harishadithyasBME/ecg-mac-accelerator-fpga/hardware/answer_key/answer_key_info.txt

ANSWER KEY - 16 real test beats, expected outputs of the validated fixed-point model

One value per line, 4 hex digits (16-bit two's complement); decision and label files: 1 hex digit.
Beat k's block starts at line k * (values per beat) of each file.

file                 values/beat  layout inside one beat
beats_in.hex         260          sample number 0..259, Q4.12 (the input buffer)
exp_conv1_relu.hex   2048         filter*256 + position, after ReLU, before pooling (the order conv1 results come out)
exp_conv1_pool.hex   1024         channel*128 + pooled position, Q6.10 (activation buffer A)
exp_conv2_relu.hex   1984         filter*124 + position, after ReLU, before pooling
exp_conv2_pool.hex   992          channel*62 + pooled position, Q6.10 = the flattened 992 values (activation buffer B)
exp_fc1.hex          32           neuron 0..31, Q7.9, after ReLU (activation buffer C)
exp_fc2.hex          2            score 0 (Normal), score 1 (Abnormal), Q6.10
exp_decision.hex     1            1 = Abnormal (score 1 > score 0), 0 = Normal
beat_labels.hex      1            true class from the data set (1 = Abnormal)

BEATS
#   test beat   true  pred  score0     score1     sat(c1,c2,fc1,fc2)  why chosen
0   19138       Nor   Nor   1.4893     -1.3457    0,0,0,0             typical Normal
1   12443       Abn   Abn   -6.8301    8.2842     0,0,0,0             typical Abnormal
2   5748        Nor   Abn   0.5811     3.6475     0,0,4,0             fc1 saturates (4 value(s))
3   5681        Nor   Abn   0.6689     2.2168     0,0,1,0             fc1 saturates (1 value(s))
4   5208        Nor   Abn   -3.3633    0.0381     0,0,0,0             largest conv1 activation
5   5747        Nor   Abn   -0.8926    6.0771     0,0,1,0             largest conv2 activation
6   5730        Nor   Abn   -3.4277    0.2012     0,0,0,0             largest fc1 value before clamp
7   12676       Nor   Abn   -1.6709    4.1729     0,0,0,0             false positive (model is wrong, hardware must be wrong the same way)
8   19716       Abn   Nor   1.0352     -0.6436    0,0,0,0             false negative (model is wrong, hardware must be wrong the same way)
9   14558       Nor   Nor   0.6133     0.6133     0,0,0,0             closest correct call to the decision boundary
10  13914       Nor   Nor   0.5889     0.5879     0,0,0,0             second closest correct call to the boundary
11  7223        Nor   Nor   2.3125     -1.9893    0,0,0,0             typical Normal
12  3520        Abn   Abn   -1.7520    3.2109     0,0,0,0             typical Abnormal
13  5413        Nor   Nor   2.0430     -1.3330    0,0,0,0             typical Normal
14  3887        Abn   Abn   -1.8076    2.1475     0,0,0,0             typical Abnormal
15  13487       Nor   Nor   1.8369     -0.9131    0,0,0,0             typical Normal
